LonghornEngineer/Pinheck_Pinball_System/README.md

Pinheck_Pinball_System
======================

Pinball system based off the PIC32 and Parallax Propeller microcontrollers

Created by:  
Benjamin J. Heckendorn  
Charlie Emery   
Parker Dillmann  

The Longhorn Engineer

http://longhornengineer.com/
