LonghornEngineer/Pinheck_Pinball_System/(threads)

Thread 1 (2020-10-01):

Pincheck manufacturing

zjobra, 2020-10-01:
Hi!
I've shared pincheck mainboard on pcbhubs for easy manufacturing order
https://pcbhubs.com/newpcb/16015432525f759c5484a18

frollard, 2020-10-01:
sanity check - the board uploaded is 79x34mm
Is it supposed to be business card sized, or are those supposed to be CM?
