LonghornEngineer/Pinheck_Pinball_System/Hardware/Pinheck Mounting Plate/Pinheck Mounting Plate.pdf

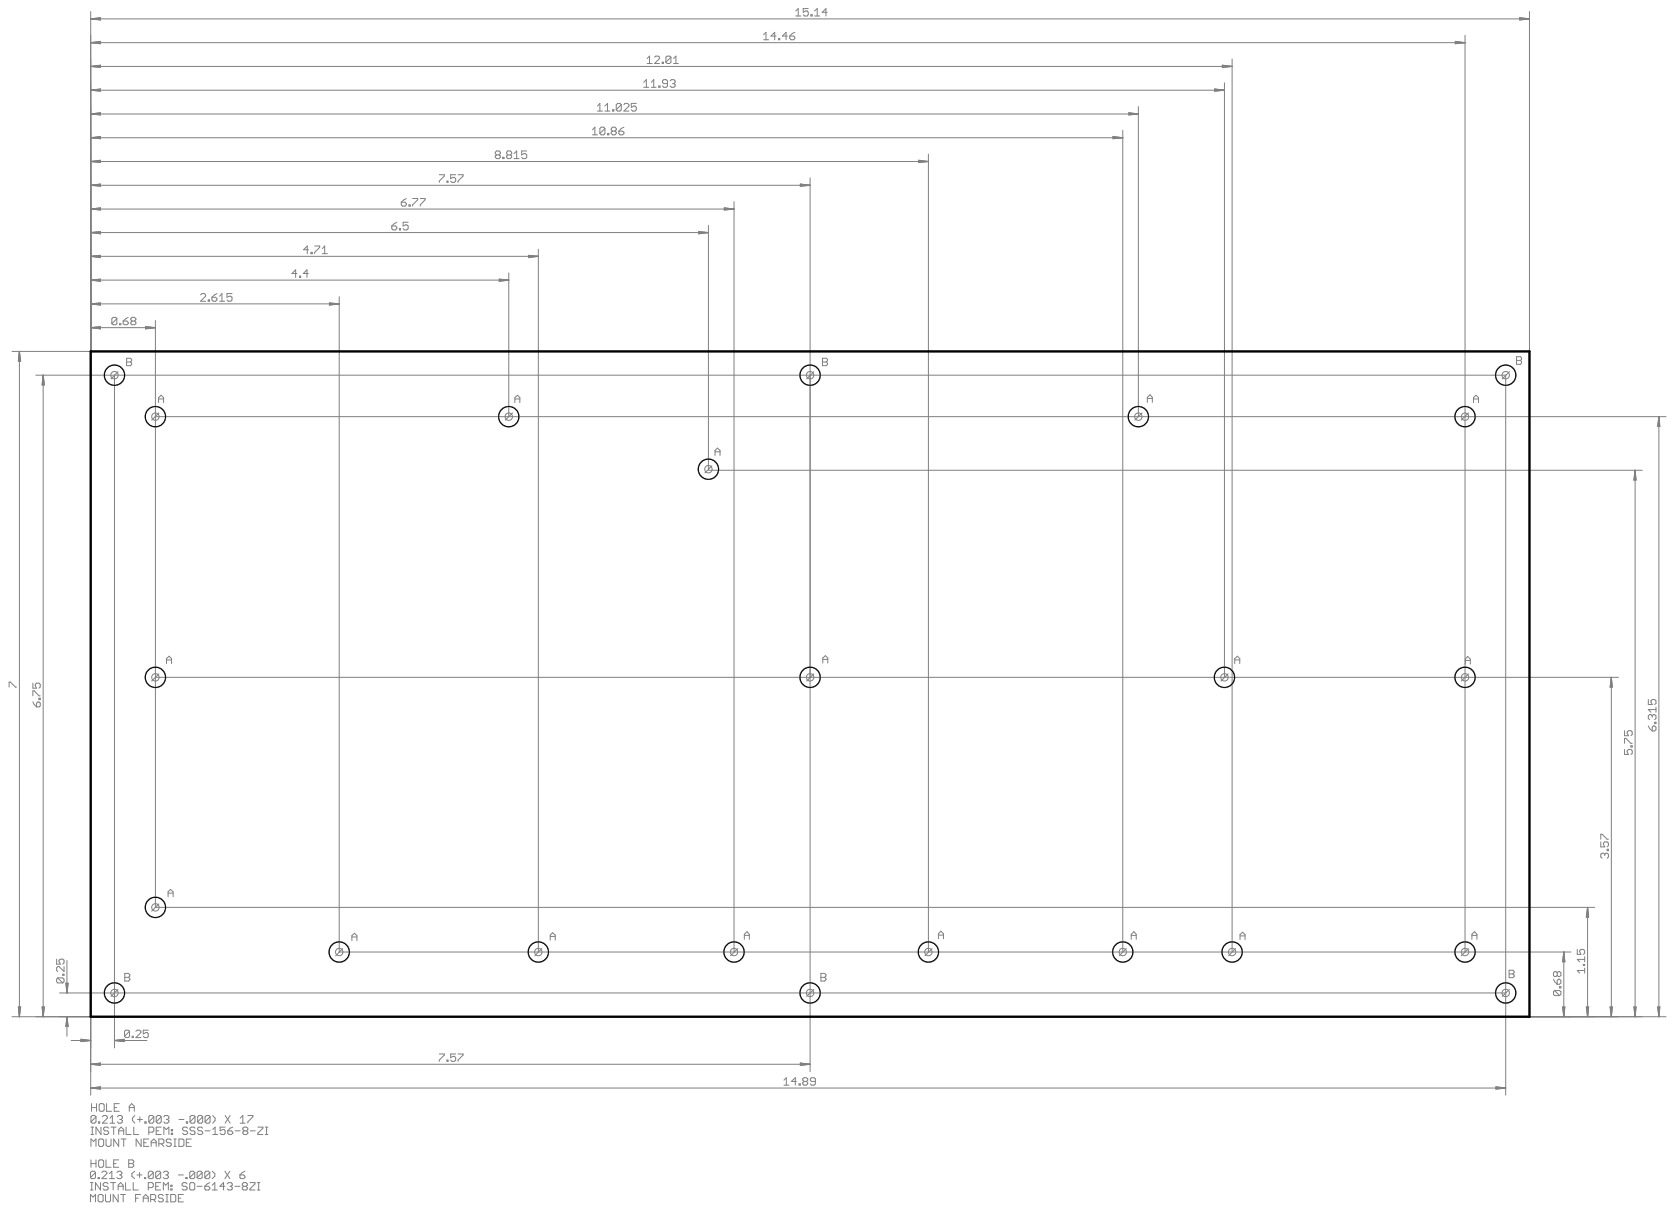
[picture p2: page 1]
