LonghornEngineer/Pinheck_Pinball_System/Hardware/RGB LED Board/RGB LED Board.brd

## EAGLE design Hardware/RGB LED Board/RGB LED Board.brd (2016-03-31)

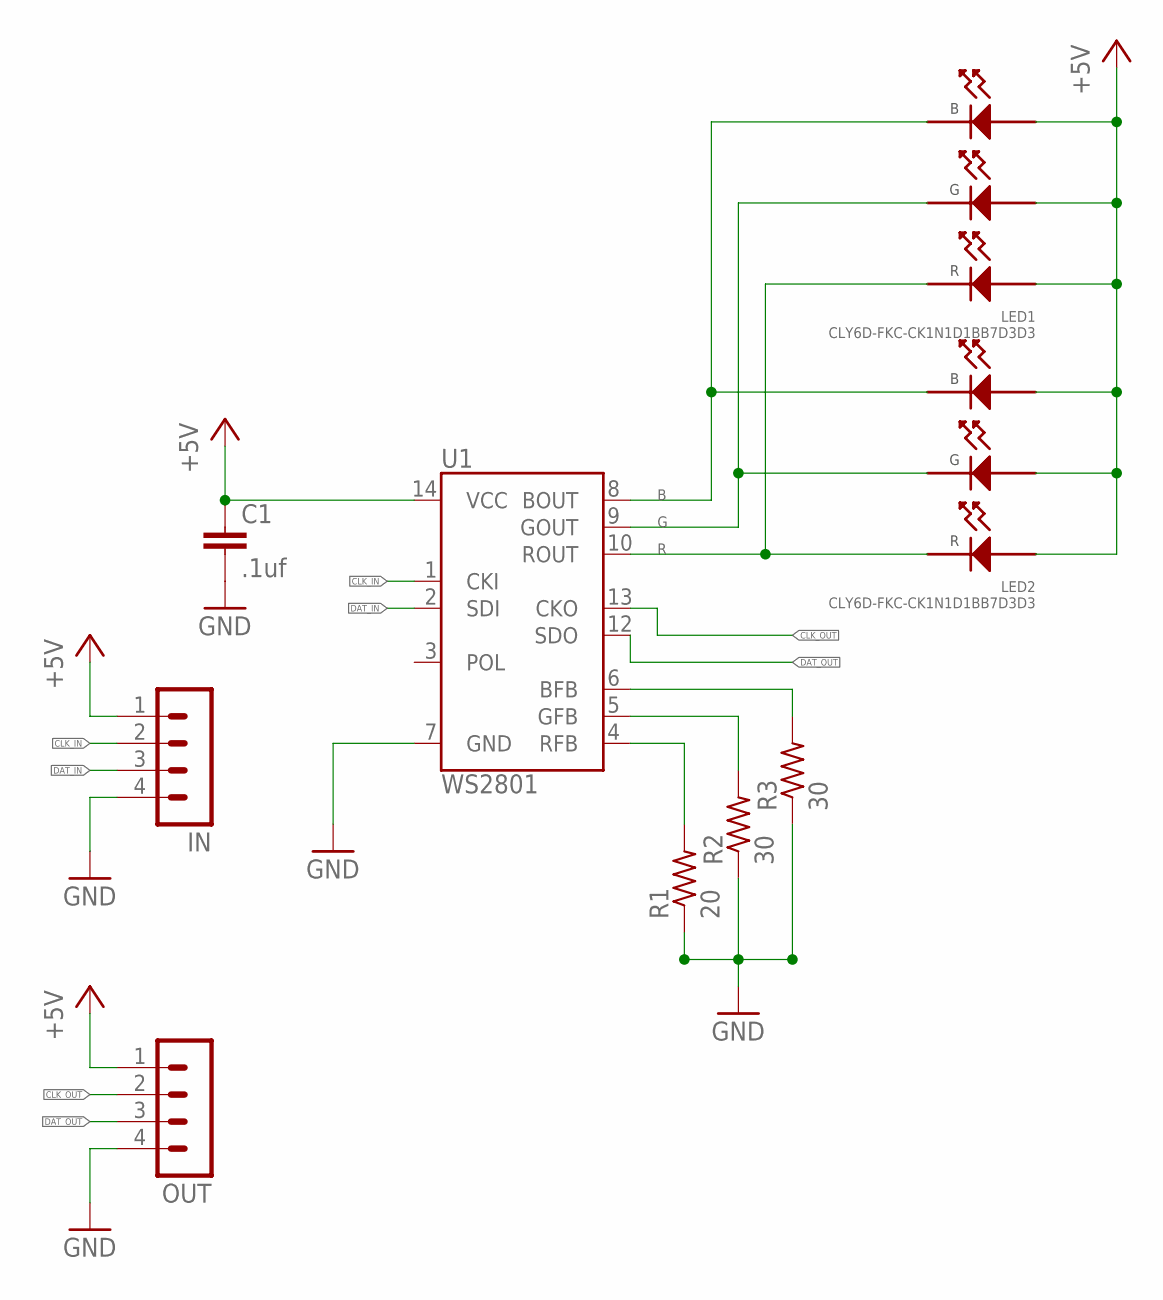
[picture p5: schematic RGB LED Board.sch]

Parts:
C1: .1uf; 0805
IN: MA04-1
LED1, LED2: CLY6D-FKC-CK1N1D1BB7D3D3; CLY6D-FKC
OUT: MA04-1
R1: 20; R0805
R2, R3: 30; R0805
U1: WS2801; SOP-14

Connections:
+5V: C1.1, IN.1, LED1.P$4 (ANODE_RED), LED1.P$5 (ANODE_GREEN), LED1.P$6 (ANODE_BLUE), LED2.P$4 (ANODE_RED), LED2.P$5 (ANODE_GREEN), LED2.P$6 (ANODE_BLUE), OUT.1, U1.14 (VCC)
B: LED1.P$1 (CATHODE_BLUE), LED2.P$1 (CATHODE_BLUE), U1.8 (BOUT)
BFB: R3.2, U1.6 (BFB)
CLK_IN: IN.2, U1.1 (CKI)
CLK_OUT: OUT.2, U1.13 (CKO)
DAT_IN: IN.3, U1.2 (SDI)
DAT_OUT: OUT.3, U1.12 (SDO)
G: LED1.P$2 (CATHODE_GREEN), LED2.P$2 (CATHODE_GREEN), U1.9 (GOUT)
GFB: R2.2, U1.5 (GFB)
GND: C1.2, IN.4, OUT.4, R1.1, R2.1, R3.1, U1.7 (GND)
R: LED1.P$3 (CATHODE_RED), LED2.P$3 (CATHODE_RED), U1.10 (ROUT)
RFB: R1.2, U1.4 (RFB)

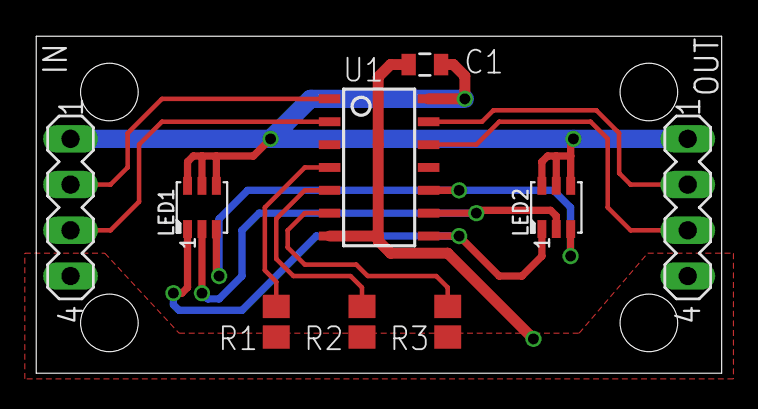
[picture p6: board RGB LED Board.brd from above]

Board: 4 copper layers, 38.1 x 18.7 mm, 9 parts (0 on the bottom side), 12 nets.
