LonghornEngineer/Pinheck_Pinball_System/Hardware/Aux Board/Aux Board.brd

## EAGLE design Hardware/Aux Board/Aux Board.brd (2016-01-26)

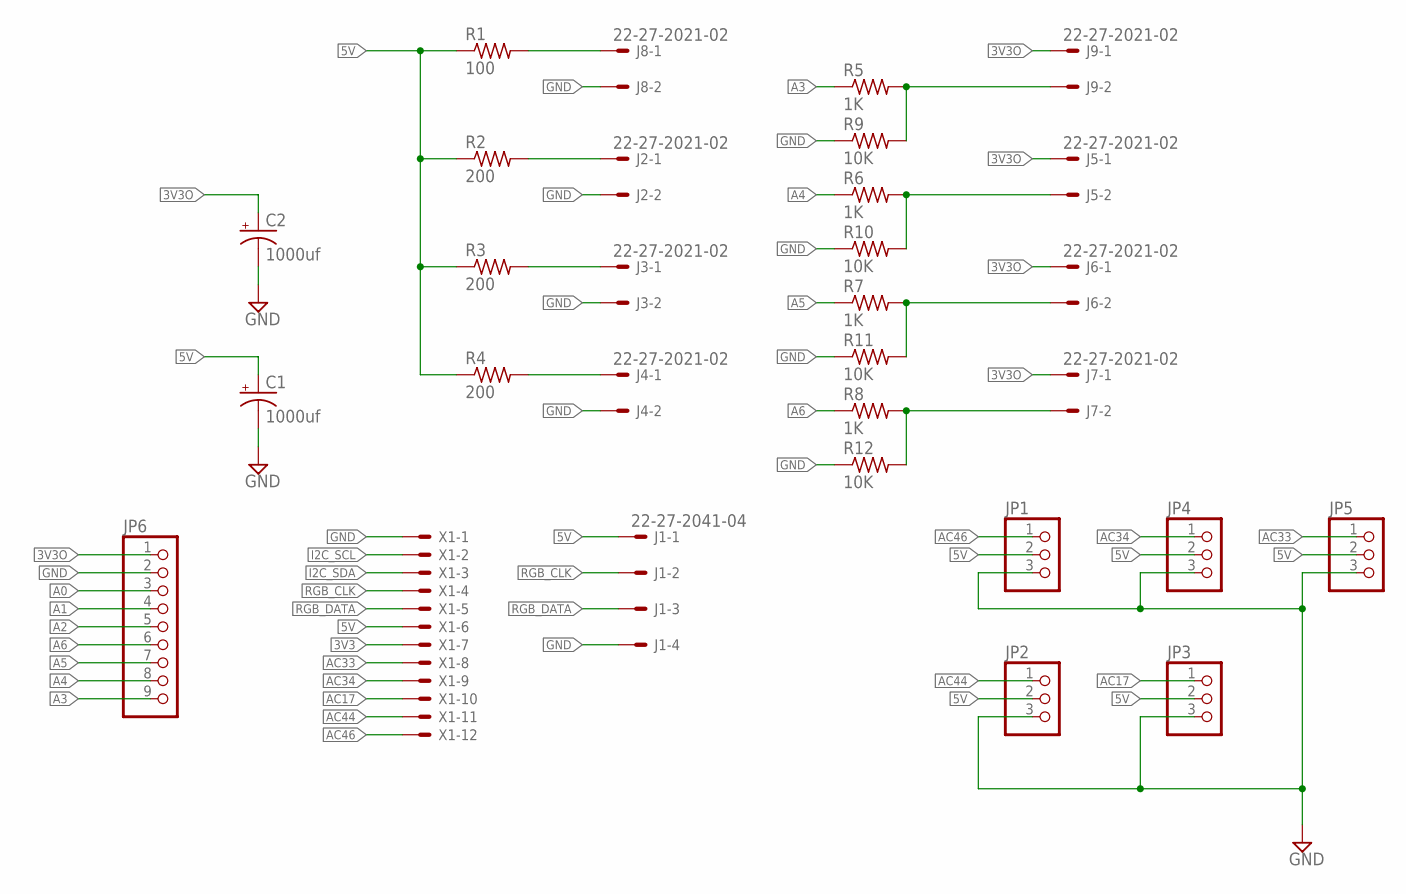
[picture p8: schematic Aux Board.sch]

Parts:
C1, C2: 1000uf; E5-8,5
J1: 22-27-2041-04; 6410-04
J2, J3, J4, J5, J6, J7, J8, J9: 22-27-2021-02; 6410-02
JP1, JP2, JP3, JP4, JP5: PINHD-1X3; 1X03
JP6: PINHD-1X9; 1X09-BIG
R1: 100; 0207/10
R2, R3, R4: 200; 0207/10
R5, R6, R7, R8: 1K; 0207/10
R9, R10, R11, R12: 10K; 0207/10
X1: KK-156-12

Connections:
3V3: X1.7
3V3O: C2.+, J5.1, J6.1, J7.1, J9.1, JP6.1
5V: C1.+, J1.1, JP1.2, JP2.2, JP3.2, JP4.2, JP5.2, R1.1, R2.1, R3.1, R4.1, X1.6
A0: JP6.3
A1: JP6.4
A2: JP6.5
A3: JP6.9, R5.1
A4: JP6.8, R6.1
A5: JP6.7, R7.1
A6: JP6.6, R8.1
AC17: JP3.1, X1.10
AC33: JP5.1, X1.8
AC34: JP4.1, X1.9
AC44: JP2.1, X1.11
AC46: JP1.1, X1.12
GND: C1.-, C2.-, J1.4, J2.2, J3.2, J4.2, J8.2, JP1.3, JP2.3, JP3.3, JP4.3, JP5.3, JP6.2, R9.1, R10.1, R11.1, R12.1, X1.1
I2C_SCL: X1.2
I2C_SDA: X1.3
unnamed: J7.2, R8.2, R12.2
unnamed: J6.2, R7.2, R11.2
unnamed: J5.2, R6.2, R10.2
unnamed: J2.1, R2.2
unnamed: J3.1, R3.2
unnamed: J4.1, R4.2
unnamed: J9.2, R5.2, R9.2
unnamed: J8.1, R1.2
RGB_CLK: J1.2, X1.4
RGB_DATA: J1.3, X1.5

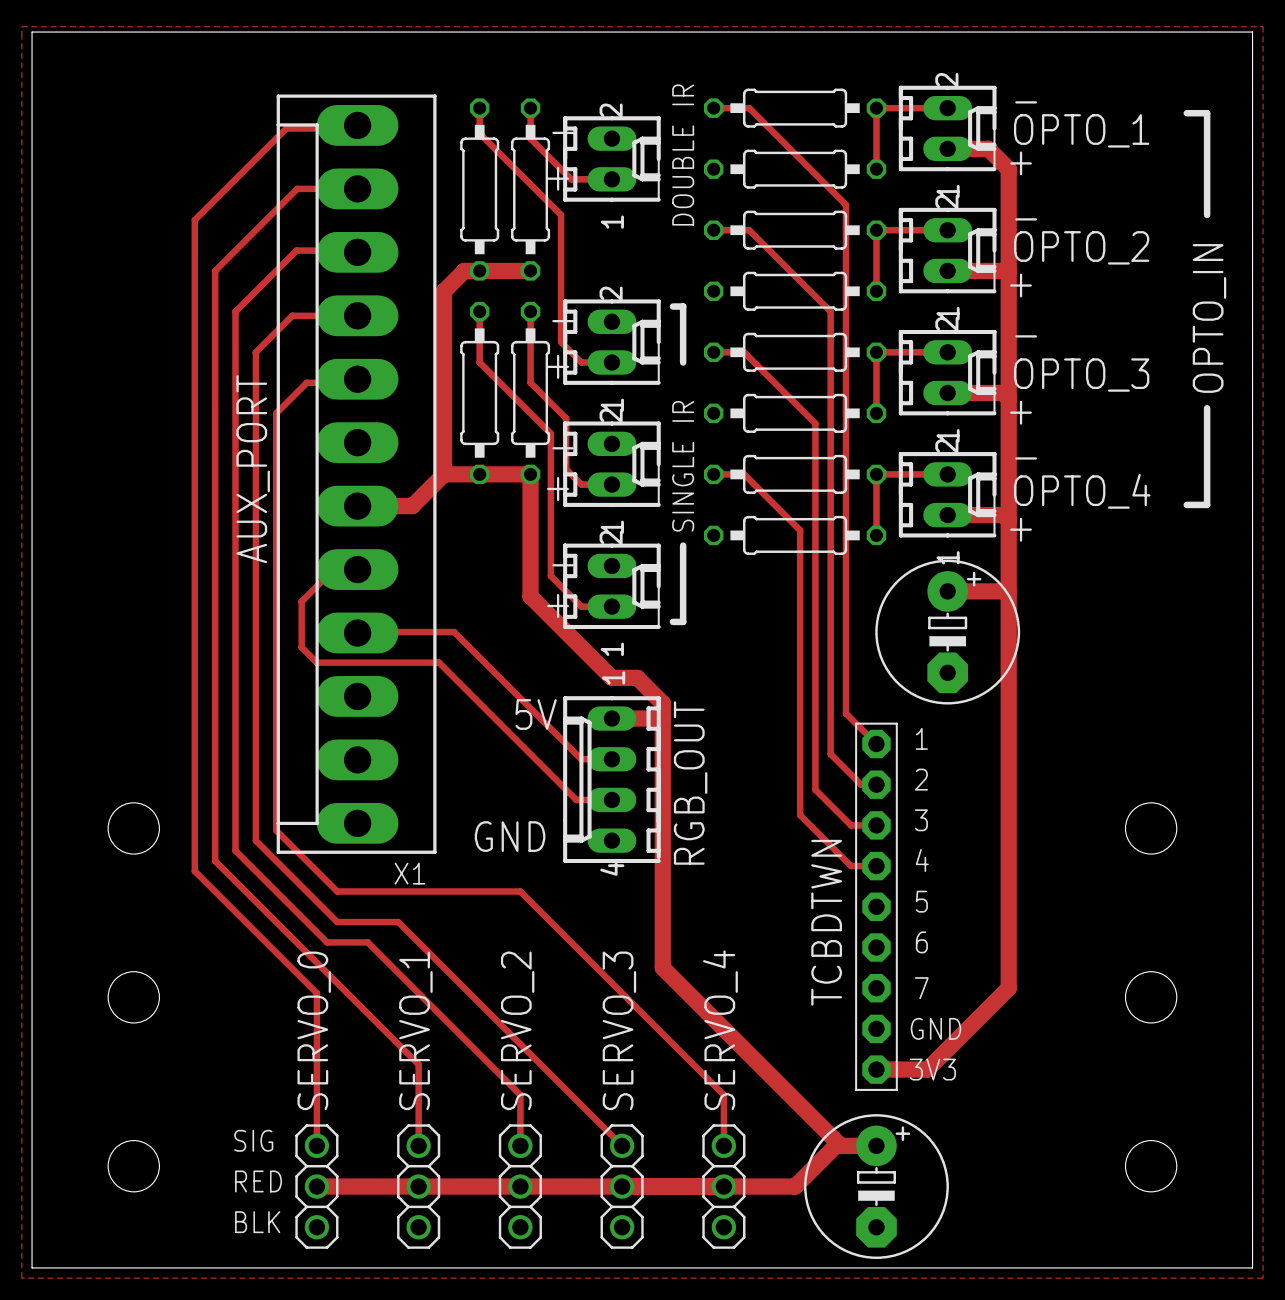
[picture p9: board Aux Board.brd from above]

Board: 4 copper layers, 76.2 x 77.1 mm, 30 parts (0 on the bottom side), 22 nets.
