LonghornEngineer/Pinheck_Pinball_System/(commit log)

2013-10-22 First revision push.
    [PinHeck.brd, PinHeck.sch]
2013-10-22 Added chipkit design files for reference.
    [chipKIT Max32.brd, chipKIT Max32.sch]
2013-10-25 Changed the alphanumeric display to be GI.
    [PinHeck.brd, PinHeck.sch]
2013-10-26 Changed Watchdog timer to work via 555timer
    [PinHeck.brd, PinHeck.sch]
2013-10-26 Fixing some layout issues. Added some breakouts.
    [PinHeck.brd, PinHeck.sch]
2013-10-26 changed port name. added new layout pic.
    [PinHeck.brd, PinHeck.sch]
2013-10-29 New Spooky Logo
    [PinHeck.brd, PinHeck.sch]
2013-11-13 Fixed spacing errors.
    [PinHeck.brd]
2013-12-06 Fixed Bill of Material Issues
    [BOM.csv, PinHeck.brd, PinHeck.sch]
2013-12-06 Fixed Part Names
    [PinHeck.brd, PinHeck.sch]
2013-12-11 Rev 5 push. Fixed Bom issues and pinout for 556.
    [BOM.csv, PinHeck.brd, PinHeck.sch]
2013-12-17 Changed some resistors to there correct number.
    [PinHeck.brd, PinHeck.sch]
2013-12-30 Changed LEDs to 0805 package.
    [PinHeck.brd, PinHeck.sch]
2014-01-08 Updated Bill of Materials.
    [BOM.csv, PinHeck.brd, PinHeck.sch]
2014-01-14 Swapped LAT and CLK on 595. FIXED.
    [PinHeck.brd, PinHeck.sch]
2014-01-19 Changed names for unused IO
    [PinHeck.brd, PinHeck.sch]
2014-01-23 Added Bluetooth
    [PinHeck.brd, PinHeck.sch]
2014-01-23 Added 2 more audio channels
    [PinHeck.brd, PinHeck.sch]
2014-01-23 Added MF Logo
    [PinHeck.brd, PinHeck.sch]
2014-01-27 Swapped TX/RX on BT module.
    [PinHeck.brd, PinHeck.sch]
2014-01-27 Updated board layout a bit.
    [PinHeck.brd, PinHeck.sch]
2014-02-10 Fixed TO-220 Hole diameter size.
    [PinHeck.brd, PinHeck.sch]
2014-02-24 Updated BOM
    [BOM.csv]
2014-02-24 Tweaked BOM script to clean up.
2014-12-23 Neo Pixel Support and Increased 5V OF DOOM
    [PinHeck.brd, PinHeck.sch]
2015-02-07 Beefed up 5V line, added caps, added AUX power con.
    [PinHeck.brd, PinHeck.sch]
2015-02-07 Changed REV number to 6
    [PinHeck.brd]
2015-02-26 Adding PNG of Schematic
2015-04-27 Adjusting file structure and adding Opto
    [Opto Detector.sch, Opto Emitter.sch, PinHeck.brd, PinHeck.sch]
2015-12-09 REV7 START
    [PinHeck.brd, PinHeck.sch]
2015-12-10 EEPROM fixed, New mounting hole sizes.
    [PinHeck.brd, PinHeck.sch]
2015-12-10 Changing out connectors.
    [PinHeck.brd, PinHeck.sch]
2015-12-10 Updating more connectors!
    [PinHeck.sch]
2015-12-14 Updated Parts to new library style!
    [PinHeck.brd, PinHeck.sch]
2015-12-15 Working on Layout now.
    [PinHeck.brd, PinHeck.sch]
2015-12-20 Part changes and new features added. Time to route.
    [PinHeck.brd, PinHeck.sch]
2015-12-20 Starting layout of parts and connectors
    [PinHeck.brd, PinHeck.sch]
2015-12-21 Layout of parts almost done. Needs some tweaking but everything fits.
    [PinHeck.brd, PinHeck.sch]
2015-12-21 Upped DRC to 6 layer and added inner power planes.
    [PinHeck.brd, PinHeck.sch]
2015-12-21 Routing the solenoid power area.
    [PinHeck.brd, PinHeck.sch]
2015-12-21 Added opto files.
    [Opto Detector.sch, Opto Emitter.sch, Opto_Detector.brd, Opto_Detector.sch, Opto_Emitter.brd, Opto_Emitter.sch, PinHeck.brd]
2015-12-21 Fixed polygon.
    [PinHeck.brd]
2015-12-22 Added changes for Ben
    [PinHeck.brd, PinHeck.sch]
2015-12-27 Routing external connectors first. Working my way inwards.
    [PinHeck.brd, PinHeck.sch]
2015-12-28 have all the peripherals layed out on the new pinheck
    [PinHeck.brd, PinHeck.sch]
2015-12-28 Prop routed. Pic32 started.
    [PinHeck.brd, PinHeck.sch]
2015-12-28 Home stretch!
    [PinHeck.brd, PinHeck.sch]
2015-12-29 MOD CON area done. Starting test header.
    [PinHeck.brd, PinHeck.sch]
2015-12-29 First draft layout complete. Still need to wire in edge connector.
    [PinHeck.brd]
2015-12-29 Added Shaker connector.
    [PinHeck.brd, PinHeck.sch]
2015-12-29 Added RGB_COM_OUT_1
    [PinHeck.brd, PinHeck.sch]
2015-12-29 Added more things to PHAM.
    [PinHeck.brd, PinHeck.sch]
2016-01-02 Adding fuses.
    [PinHeck.brd, PinHeck.sch]
2016-01-04 TPS chips added and fuses added.
    [PinHeck.brd, PinHeck.sch]
2016-01-05 started edge con routing.
    [PinHeck.brd, PinHeck.sch]
2016-01-11 more routing!
    [PinHeck.brd, PinHeck.sch]
2016-01-15 Layout done. Silkscreen and TP to do!
    [PinHeck.brd, PinHeck.sch]
2016-01-15 Started Test Points
    [PinHeck.brd, PinHeck.sch]
2016-01-15 Test points almost done!
    [PinHeck.brd, PinHeck.sch]
2016-01-16 finished test points.
    [PinHeck.brd, PinHeck.sch]
2016-01-16 Layout complete and silkscreen almost done!
    [PinHeck.brd, PinHeck.sch]
2016-01-17 Silkscreen done.
    [PinHeck.brd, PinHeck.sch]
2016-01-18 REV 7 preliminary done.
    [PinHeck.brd, PinHeck.sch]
2016-01-22 Added AUX power Connector
    [PinHeck.brd, PinHeck.sch]
2016-01-24 pushing first of test jig.
    [PinHeck Test Jig.brd, PinHeck Test Jig.sch]
2016-01-26 Added AUX, and RGB LED Board. Working on Test Jib.
    [Aux Board.brd, Aux Board.sch, PinHeck Test Jig.brd, PinHeck Test Jig.sch, RGB LED Board.brd, RGB LED Board.sch, chipKIT Max32.brd, chipKIT Max32.sch]
2016-01-26 Jig Schematic Done.
    [PinHeck Test Jig.brd, PinHeck Test Jig.sch]
2016-01-26 Routing Test Jig.
    [PinHeck Test Jig.brd, PinHeck Test Jig.sch]
2016-01-27 Still routing!
    [PinHeck Test Jig.brd, PinHeck Test Jig.sch]
2016-01-27 More work done. Fixed size issue.
    [PinHeck Test Jig.brd, PinHeck Test Jig.sch]
2016-01-29 Almost done!
    [PinHeck Test Jig.brd, PinHeck Test Jig.sch]
2016-01-29 routing almost done.
    [PinHeck Test Jig.brd, PinHeck Test Jig.sch]
2016-01-29 Almost done.
    Need to change drill size.
    [PinHeck Test Jig.brd, PinHeck Test Jig.sch]
2016-01-30 Test Jig done.
    [PinHeck Test Jig.brd, PinHeck Test Jig.sch]
2016-02-03 Added mounting plate for Pinheck
    [Pinheck Mounting Plate.brd]
2016-02-07 Added 1M pullup to EN pin on the TPS25925x/6x
    [PinHeck.brd, PinHeck.sch]
2016-02-07 Fixed 4628
    [PinHeck.brd, PinHeck.sch]
2016-02-11 Fixed Pinheaders
    [PinHeck.brd, PinHeck.sch]
2016-02-11 Added LED Fuse Indicators and BATT POS mark
    [PinHeck.brd, PinHeck.sch]
2016-02-29 Added silkscreen.
    [PinHeck.brd]
2016-03-31 changed LED to CLY6D-FKC-CK1N1D1BB7D3D3
    [RGB LED Board.brd, RGB LED Board.sch]
2016-04-12 GI and Solenoids working. WIP
2016-04-13 Preliminary Code Done. Need PROP testing.
2016-04-18 Test code for the PROP complete. Needs testing on the Fixture.
2016-04-19 Added code to make Prop Program Prop!
2016-04-19 Test code now programs and tests Prop side.
2016-04-27 Working on changes for REV 7C
    Changed Audio connector to SJ1-3533NS
    [PinHeck.brd, PinHeck.sch]
2016-04-27 Fixed Start LED
    [PinHeck.brd, PinHeck.sch]
2016-08-24 Starting S^3
    [Spooky Sound System.brd, Spooky Sound System.sch]
2016-12-13 tone control done.
    [Spooky Sound System.brd, Spooky Sound System.sch]
2016-12-13 PinHeck REV7D. Changed Battery connector.
    [PinHeck.GBL, PinHeck.GBO, PinHeck.GBP, PinHeck.GBS, PinHeck.GTL, PinHeck.GTO, PinHeck.GTP, PinHeck.GTS]
2016-12-13 Schematic done. Start Routing.
    [Spooky Sound System.brd, Spooky Sound System.sch]
2017-01-25 Starting layout...
    [Spooky Sound System.brd, Spooky Sound System.sch]
2017-01-26 Parts layed out
    [Spooky Sound System.brd, Spooky Sound System.sch]
2017-01-31 routing about halfway finished.
    [Spooky Sound System.brd, Spooky Sound System.sch]
2017-02-01 Initial routing done.
    [Spooky Sound System.brd, Spooky Sound System.sch]
2017-02-02 Cleaning up the routing...
    [Spooky Sound System.brd]
2017-02-08 Finished routing
    Just needs tweaking and final look over.
    [Spooky Sound System.brd, Spooky Sound System.sch]
2017-03-28 adding RPI3 LVDS board.
    [RPI3_LVDS.brd, RPI3_LVDS.sch]
2017-03-28 Uploading camfiles and manufacturing data.
    [RPI3_LVDS.GBL, RPI3_LVDS.GBO, RPI3_LVDS.GBP, RPI3_LVDS.GBS, RPI3_LVDS.GTL, RPI3_LVDS.GTO, RPI3_LVDS.GTP, RPI3_LVDS.GTS]
2017-04-21 Fixed LM1085
    [RPI3_LVDS.brd, RPI3_LVDS.sch]
2017-04-21 updated manufacturing files.
    [RPI3_LVDS.GBL, RPI3_LVDS.GBO, RPI3_LVDS.GTL, RPI3_LVDS.XLN]
2019-01-15 Removing older boards
    [RPI3_LVDS.GBL, RPI3_LVDS.GBO, RPI3_LVDS.GBP, RPI3_LVDS.GBS, RPI3_LVDS.GTL, RPI3_LVDS.GTO, RPI3_LVDS.GTP, RPI3_LVDS.GTS]
