LonghornEngineer/Pinheck_Pinball_System/Hardware/Pinheck Main Board/Layout.png

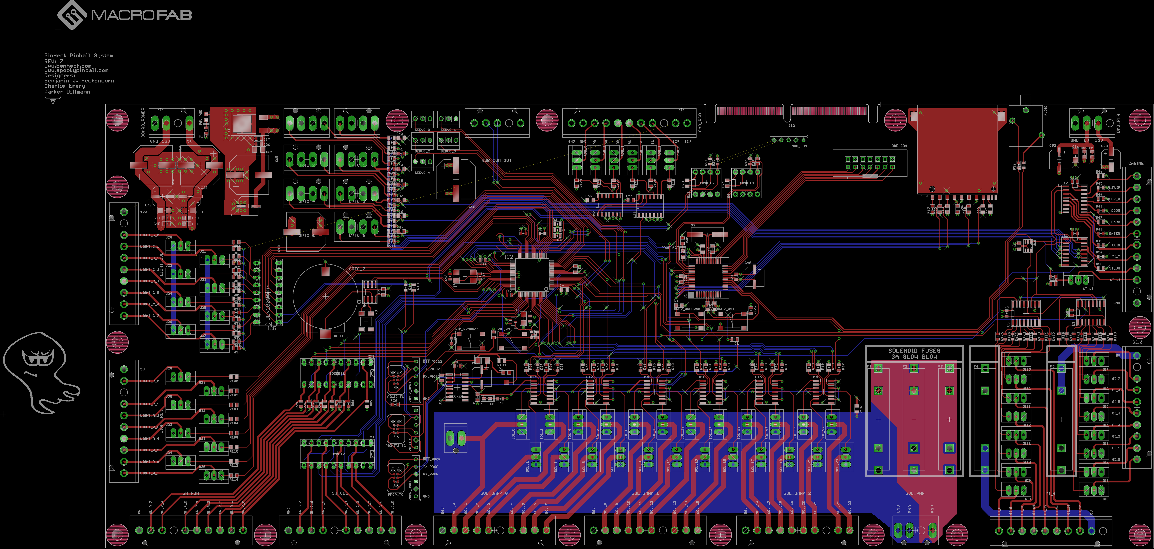
Hardware/Pinheck Main Board/Layout.png
